ken20001207/TMD-Arduino/Mega2560/global.h

#ifndef __global_h__
#define __global_h__
#include <SoftwareSerial.h>
#include <ArduinoJson.h>
#include <LiquidCrystal_I2C.h>
#include <paj7620.h>
#include <Adafruit_NeoPixel.h>
#include <MsTimer2.h>
extern LiquidCrystal_I2C lcd;
extern Adafruit_NeoPixel strips[];
void printTextLCD(LiquidCrystal_I2C lcd, char *line1, char *line2);
#endif
