ken20001207/TMD-Arduino/(commit log)

2020-08-04 add some led modes
2020-08-24 add led
